phatdattran2k2/recycleright/report/PRESENTATION_FINAL.pptx

RecycleRight

AI-Powered Waste Sorting System on Jetson Orin Nano

陳發達 (611451001) · 楊瑋竣 (411201107)

Supervisor: Prof. 宋建龍 | Tatung University | I4210 AI Edge Computing Practicum | June 2026

## Slide 2

Problem Statement & Motivation

The Problem

Recycling contamination from wrong-bin deposits is the #1 cause of recyclables going to landfill. Taiwan's source-separation rules require 4 distinct categories. Static signs alone don't work.

Why Edge AI on Jetson Orin Nano?

Video never leaves device — no cloud transmission

< 30 ms vs 300+ ms cloud round-trip → servo responds instantly

Servo motors need direct hardware control via ESP32

15–25 W always-on vs 150–350 W desktop GPU

🔒

Privacy

⚡

Latency

Who Benefits

University campuses, cafeterias, office floors — any high-traffic shared space with multi-bin stations. Venue operators, recycling processors, and end-users all benefit.

🔌

GPIO/UART

💡

Power

## Slide 3

Final System Architecture

SENSE

PROCESS

DECIDE

ACT

IMX219 CSI
1280×720 @60fps
GStreamer
nvarguscamerasrc

→

YOLOv8n
TRT FP16
conf ≥ 0.50
~23 ms/frame

→

10-frame vote
≥6 hits wins
lid_ready sync
DONE handshake

→

ESP32+PCA9685
4× SG90 servo
4× status LED
ffplay audio

4 Concurrent Threads

T1 CameraCapture

T2 Detector

T3 SerialController

T4 HUD/tegrastats

ESP32 (USB UART 115200) → PCA9685 I²C (addr 0x40) → 4× SG90 servo | Sequence: LED ON → 120° → 5s hold → 0° → LED OFF → DONE:<label> | lid_ready Event released

## Slide 4

What Changed vs the Proposal

YOLOv8n has more mature TRT FP16 export on JetPack 6 / TRT 10.7. Same accuracy class, better toolchain stability.

Model

❌ YOLOv12n (proposed)

✅ YOLOv8n TRT FP16 (shipped)

Decouples servo PWM from Jetson. DONE handshake provides clean mutual exclusion without asyncio complexity.

Actuator Control

❌ Direct Jetson GPIO servo

✅ ESP32 + PCA9685 via UART

Single-device deployment — direct Python primitives are lower latency and simpler to test than an MQTT round-trip.

Messaging

❌ MQTT broker (Mosquitto)

✅ threading.Queue + Event

GPIO contention with PCA9685 I²C. Low-vote rejections handled by no-action + audio announcement instead.

Red rejection LED

❌ GPIO-driven red LED

✅ Removed

## Slide 5

AI Model & Optimization Choices

YOLOv8n

Architecture

TRT FP16

Precision

640×640

Input Size

4 classes

Categories

0.50

Conf. Threshold

96.02%

mAP@50

Dataset: Custom 12,571 images (10,056 train / 1,257 val / 1,258 test), collected with IMX219 at Tatung University lab. Labeled with Roboflow.
Training: PC server, YOLOv8n pretrained COCO, 100 epochs AdamW, best checkpoint at epoch 0 (pretrained weights already excellent).
Export: model.export(format='engine', half=True) on-device — TRT engine built for Orin Nano SM 8.7 / TRT 10.7 / CUDA 12.6.

Training & Export Pipeline

## Slide 6

Implementation

Highlights

## Slide 7

Implementation Highlights

MOG2 Motion-Gated Inference

Every frame passes MOG2 background subtraction first (~1 ms CPU). YOLO inference (~23 ms GPU) only runs if a foreground contour exceeds MIN_AREA = 500 px². This gate suppresses > 95% of inference calls on idle frames — the reason live GPU utilization is ~55% rather than saturated, preserving thermal headroom for bursty item presentation.

01

10-Frame Majority Voting + lid_ready Interlock

We accumulate VOTE_FRAMES=10 frames and require VOTE_THRESHOLD=6 (≥60%) agreement before dispatching. Once a command is sent, lid_ready.clear() prevents any further dispatch until the ESP32 sends DONE:<label>\n back. Two layers of false-positive protection: statistical confidence + hardware interlock.

02

TRT FP16 On-Device Export

best.pt (FP32) → best_fp16.engine via model.export(format='engine', half=True) running on the Jetson itself. TRT engines are compiled for a specific SM version and CUDA version — never copy .engine files between machines. Export takes ~3–5 min; loads in <2 s at inference time.

03

## Slide 8

Implementation Highlights (continued)

ESP32 Firmware — Busy Guard & Serial Flush

The busy flag in the Arduino loop() ignores all incoming serial bytes during an active sort cycle. After the servo sequence completes, while(Serial.available()) Serial.read() flushes the buffer before sending DONE: — preventing any queued ghost commands from triggering a second sort. Discovered through direct physical observation: the servo opened twice on a single item.

04

5-Stage CI/CD Pipeline on Self-Hosted Jetson Runner

lint → test (≥90% coverage) → security-scan (bandit + pip-audit) → build (arm64 Docker → GHCR) → integration-test (pulls image on Jetson runner, end-to-end test). The conftest.py mock layer lets all unit tests run on Ubuntu cloud runners with no GPU, camera, or serial port. Only integration-test requires the real Jetson.

05

Jetson → ESP32: PET\n | GLS\n | MTL\n | PAP\n ESP32 → Jetson: DONE:PET bottle\n | DONE:Glass bottle\n | ...

UART Protocol:

## Slide 9

CI/CD Pipeline — 5-Stage GitHub Actions

lint

ruff check
zero violations

test

pytest
≥90% coverage

security

bandit
pip-audit

build

arm64 Docker
push GHCR

integration

Jetson runner
end-to-end

Self-Hosted Jetson

→

→

→

→

GitHub-Hosted (Ubuntu — no GPU needed)

Trigger

Push to main
+ Pull Request

Coverage

--cov-fail-under=90
93 tests pass

Security

0 high-severity
bandit findings

Image tag

sha-<commit>
+ :latest float

Deploy

Tag v* triggers
deploy.yml

Tag-triggered deploy.yml: git tag v1.0.0 → push → Jetson runner pulls GHCR image → deploy.sh → healthcheck.sh → rollback.sh available (< 30 s to previous tag)

## Slide 10

Test Set & Methodology

Class

Train

Val

Test

Total

PET bottle

Aluminum can

5,093

2,557

654

304

673

297

6,420

3,158

Glass bottle

2,300

255

305

2,860

Tetra Pak

1,820

271

221

2,312

Total instances

11,770

1,484

1,496

14,750

Accuracy Measurement

• model.val() on held-out test split (1,258 images)
• Eval on best.pt FP32 (training server)
• Deploy as best_fp16.engine (< 0.5 mAP drop expected)
• conf=0.50, IoU=0.70

Performance Instrumentation

• FPS: pipeline-level counter in Detector thread
• Latency: time.perf_counter() around model() call
• GPU%/Power: sudo tegrastats --interval 1000
• Parsed by scripts/parse_tegrastats.py → utilization.csv
• 449 samples @ 1 Hz, ≥60 s sustained live run

## Slide 11

Performance Requirements & Optimization Journey

≥25 FPS

Target FPS

≤60 ms

p95 Latency

≥0.80

mAP@50

≤15 W

VDD_IN

≥40% GPU

GPU Utilization

≤60% CPU

CPU Headroom

Step

Change

FPS

p50 ms

GPU%

Power W

Note

Step 0 — FP32

best.pt 15W

39.5

24.8

73%

8.7 W

Baseline

Step 1 — FP16

TRT FP16 15W

43.1

22.9

67%

7.5 W ↓14%

Best power efficiency

Step 2 — 25W

FP16 + 25W mode

44.8

21.2

62%

7.5 W

Marginal +4% FPS

Step 3 — MAXN

FP16 + MAXN mode

44.4

21.8

66%

7.8 W

No gain vs 25W

Step 4 — Live

MOG2 + 4 threads

gated

N/A

55%

10.8 W

Final deployment

★ All 6 targets met: FPS 43.1≥25 ✅ p95 30.2ms≤60ms ✅ mAP 96.02%≥80% ✅ Power 7.5W≤15W ✅ GPU 55%≥40% ✅ CPU 48.5%≤60% ✅

## Slide 12

Results — Accuracy & Performance

96.02%

mAP@50

96.95%

Precision

96.38%

Recall

96.66%

F1 Score

Per-class AP@50

Aluminum can (best)

Mode

FPS

p50ms

p95ms

97.30%

15W (FP16)

43.1

22.9

30.2

PET bottle

96.19%

25W (FP16)

44.8

21.2

31.8

Tetra Pak

95.65%

MAXN (FP16)

Live Pipeline (tegrastats, 449 samples)

CPU avg: 32.1% GPU avg: 45.3%
VDD_IN avg: 6,712 mW (6.7 W)
VDD_IN peak: 8,124 mW (8.1 W)
No thermal throttling observed

44.4

21.8

30.9

Glass bottle (lowest)

94.95%

## Slide 13

LIVE DEMO

Sense → Process → Decide → Act

1. Jetson powered on — tegrastats visible in corner

2. Live IMX219 CSI camera feed — NOT a pre-recorded video

3. YOLOv8n TRT FP16 inference — bounding boxes + FPS counter

4. 10-frame voting window reaches threshold → decision fires

5. SG90 servo opens to 120° — bin lid physically moves

6. Mandarin audio announcement plays — confirms item category

7. ESP32 sends DONE: → lid closes → system unlocks for next item

(Recorded backup available if live setup fails)

## Slide 14

Lessons Learned

TRT Engine Must Be Built on Target Device

Tried exporting on laptop (x86 CUDA 11.8) and copying .engine to Jetson → GPU architecture mismatch error. TRT compiles for a specific SM version. Always run export_fp16.py on the Jetson itself. Cost us one full day.

1

GStreamer Pipelines Are Not Portable

nvarguscamerasrc only works on JetPack Jetson systems. Our conftest.py mock layer solved this: mock cv2.VideoCapture at import time → 90%+ coverage on cloud runners with no camera.

2

MOG2 Thresholds Require In-Situ Calibration

MIN_AREA=200 triggered false positives from fluorescent flicker. Raised to 500. The right value depends on camera height, lighting, and bin opening size — cannot be determined from a dataset alone.

3

lid_ready Interlock Was Not in the Original Design

Discovered in integration testing: removing an item before the vote window closed could queue two commands. The Event-based interlock completely eliminates this race condition. Patterns we didn't anticipate during the proposal phase.

4

tegrastats Format Changed in JetPack 6.x

VDD_CPU_GPU_CV replaced POM_5V_GPU. CPU frequency format changed. Our parse_tegrastats.py uses regex fallbacks for both JetPack 5 and 6. Always test parsers against actual log output before trusting numbers.

5

## Slide 15

What We'd Do Differently

Decide INT8 vs FP16 at Week 1, not Week 13. We scaffolded a calibration/ directory but never populated it. Benchmark both on a small test set early and commit to one path.

1

Both

Write integration tests before wiring the actuator. We spent Week 13 retrofitting tests around code that was already running on hardware. Contracts first, implementation second.

2

楊瑋竣

Run class-distribution analysis at Week 9, not Week 14. Glass bottle AP was lowest (94.95%). Knowing this earlier would have let us collect more samples while time permitted.

3

陳發達

Pin nvpmodel mode in deploy.sh. During demos we forgot which power mode was active. One line of sudo nvpmodel -m 1 in deploy.sh ensures reproducible performance on every deploy.

4

陳發達

Register the self-hosted Jetson runner at Week 10, not Week 14. Setup takes 30 minutes. Starting earlier means catching integration failures weeks sooner, when there's still time to fix them.

5

Both

## Slide 16

Thank You

Questions & Answers

陳發達 (611451001) — Hardware integration, ESP32 firmware, dataset, model training, benchmarking

楊瑋竣 (411201107) — Software architecture, CI/CD pipeline, test suite, parse_tegrastats.py

Anticipate:

❓ Why YOLOv8n over YOLOv12n?

❓ What if the camera disconnects?

❓ How would this scale to 50 devices?

❓ What's the worst failure mode observed?

❓ Walk through what CI does on a PR

GitHub: github.com/phatdattran2k2/recycleright | Supervisor: Prof. 宋建龍 | June 2026
