phatdattran2k2/recycleright/scripts/benchmark_offline_result.csv

timestamp | power_mode | n_images | loops | fps | n_samples | p50_ms | p95_ms | p99_ms | mean_ms | min_ms | max_ms | cpu_avg_pct | gpu_avg_pct | vdd_in_avg_mw | vdd_in_peak_mw
2026-06-07 22:49:10 | Mode 0 (15W) | 320 | 3 | 43.1 | 960 | 22.9 | 30.2 | 35.2 | 23.2 | 14.6 | 50.2 | 39.1 | 66.5 | 7507 | 8464
2026-06-07 22:50:27 | Mode 1 (25W) | 320 | 3 | 44.8 | 960 | 21.2 | 31.8 | 34.6 | 22.3 | 14.3 | 37.2 | 36.6 | 61.9 | 7459 | 7888
2026-06-07 22:51:23 | Mode 2 (MAXN_SUPER) | 320 | 3 | 44.4 | 960 | 21.8 | 30.9 | 35.1 | 22.5 | 14.7 | 37.3 | 37.2 | 65.6 | 7833 | 9066
