phatdattran2k2/recycleright/report/test_CI_CD.png

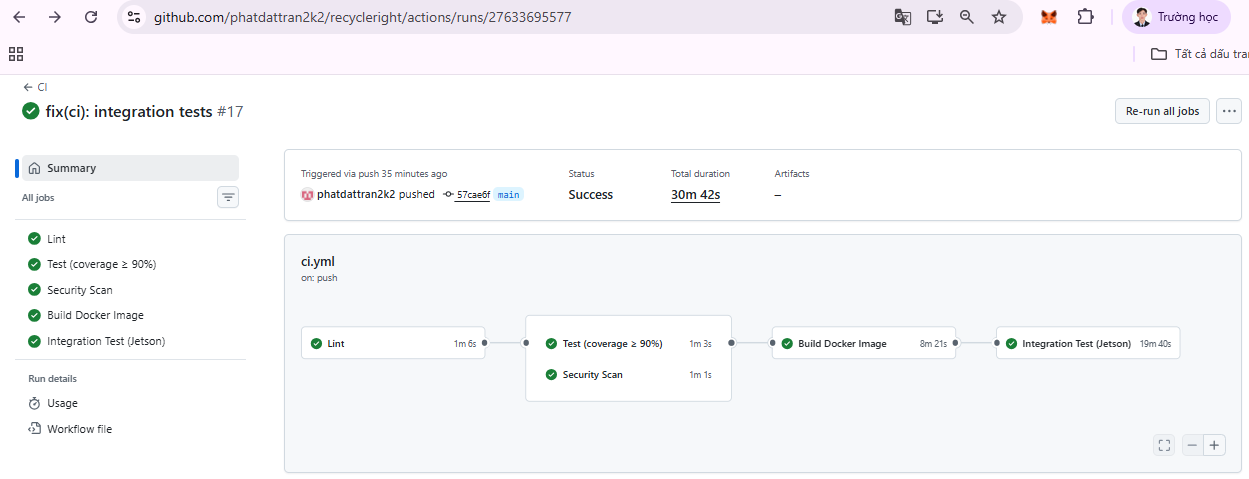
report/test_CI_CD.png
