phatdattran2k2/recycleright/tests/test_src_coverage.py

#!/usr/bin/env python3
# Copyright (c) 2026 陳發達_楊瑋竣
# Tatung University — I4210 AI實務專題

"""Coverage tests — import thật từ src/ với mocks đã setup trong root conftest.py"""

import contextlib
import queue
import threading
import unittest
from unittest.mock import MagicMock, patch

import src.detector as det_module
from src.audio import CLASS_AUDIO, AudioPlayer
from src.camera import GST, CameraCapture
from src.hud import HUD
from src.serial_controller import SerialController

# ═══════════════════════════════════════════════════════════════════════════════
# src/audio.py
# ═══════════════════════════════════════════════════════════════════════════════


class TestAudioSrc(unittest.TestCase):

    def test_four_classes_mapped(self):
        self.assertEqual(len(CLASS_AUDIO), 4)

    def test_all_expected_labels(self):
        for label in ["PET bottle", "Glass bottle", "Aluminum can", "Tetra Pak"]:
            self.assertIn(label, CLASS_AUDIO)

    def test_all_values_are_mp3(self):
        for path in CLASS_AUDIO.values():
            self.assertTrue(path.endswith(".mp3"), f"{path} not .mp3")

    def test_unknown_label_none(self):
        self.assertIsNone(CLASS_AUDIO.get("Unknown"))

    @patch("src.audio.shutil.which")
    @patch("src.audio.subprocess.Popen")
    def test_play_known_calls_ffplay(self, mock_popen, mock_which):
        mock_which.return_value = "/usr/bin/ffplay"
        AudioPlayer.play("PET bottle")
        mock_popen.assert_called_once()
        cmd = mock_popen.call_args[0][0]
        self.assertEqual(cmd[0], "/usr/bin/ffplay")
        self.assertIn("-nodisp", cmd)
        self.assertIn("-autoexit", cmd)

    @patch("src.audio.shutil.which")
    @patch("src.audio.subprocess.Popen")
    def test_play_unknown_no_call(self, mock_popen, mock_which):
        mock_which.return_value = "/usr/bin/ffplay"
        AudioPlayer.play("Unknown")
        mock_popen.assert_not_called()

    @patch("src.audio.shutil.which")
    @patch("src.audio.subprocess.Popen")
    def test_play_all_four_classes(self, mock_popen, mock_which):
        mock_which.return_value = "/usr/bin/ffplay"
        for label in CLASS_AUDIO:
            mock_popen.reset_mock()
            AudioPlayer.play(label)
            mock_popen.assert_called_once()


# ═══════════════════════════════════════════════════════════════════════════════
# src/serial_controller.py
# ═══════════════════════════════════════════════════════════════════════════════


class TestSerialControllerSrc(unittest.TestCase):

    def _make(self):
        stop = threading.Event()
        lid  = threading.Event()
        lid.set()
        ctrl = SerialController("/dev/ttyUSB0", 115200, stop, lid)
        return ctrl, stop, lid

    def test_not_connected_no_port(self):
        ctrl, _, _ = self._make()
        self.assertFalse(ctrl.connected)

    def test_send_no_crash_when_disconnected(self):
        ctrl, _, _ = self._make()
        ctrl.send(b"PET\n")  # must not raise

    def test_close_no_crash_when_disconnected(self):
        ctrl, _, _ = self._make()
        ctrl.close()  # must not raise

    def test_run_exits_when_stop_set(self):
        ctrl, stop, _ = self._make()
        stop.set()
        t = threading.Thread(target=ctrl.run, daemon=True)
        t.start()
        t.join(timeout=1.0)
        self.assertFalse(t.is_alive())

    def test_done_line_sets_lid_ready(self):
        """Unit-test the DONE parsing logic inline."""
        lid = threading.Event()
        lid.clear()
        line = "DONE:PET bottle"
        if line.startswith("DONE:"):
            lid.set()
        self.assertTrue(lid.is_set())

    def test_non_done_line_no_set(self):
        lid = threading.Event()
        lid.clear()
        for line in ["Ready.", "【收到】PET bottle", ""]:
            if line.startswith("DONE:"):
                lid.set()
        self.assertFalse(lid.is_set())

    def test_connected_property_false(self):
        ctrl, _, _ = self._make()
        self.assertIsInstance(ctrl.connected, bool)


# ═══════════════════════════════════════════════════════════════════════
# src/hud.py
# ═══════════════════════════════════════════════════════════════════════


class TestHUDSrc(unittest.TestCase):

    def _make(self):
        stop = threading.Event()
        return HUD(stop), stop

    def test_initial_fps_zero(self):
        hud, _ = self._make()
        self.assertEqual(hud.fps, 0.0)

    def test_initial_gpu_pct_minus_one(self):
        hud, _ = self._make()
        self.assertEqual(hud.gpu_pct, -1)

    def test_initial_gpu_mw_minus_one(self):
        hud, _ = self._make()
        self.assertEqual(hud.gpu_mw, -1)

    def test_set_fps_updates(self):
        hud, _ = self._make()
        hud.set_fps(39.5)
        self.assertAlmostEqual(hud.fps, 39.5)

    def test_set_fps_zero(self):
        hud, _ = self._make()
        hud.set_fps(0.0)
        self.assertAlmostEqual(hud.fps, 0.0)

    def test_set_fps_thread_safe(self):
        hud, _ = self._make()
        def writer():
            for i in range(50):
                hud.set_fps(float(i))
        t = threading.Thread(target=writer)
        t.start()
        t.join()
        self.assertGreaterEqual(hud.fps, 0.0)

    def test_run_exits_when_stop_set(self):
        hud, stop = self._make()
        stop.set()
        t = threading.Thread(target=hud.run, daemon=True)
        t.start()
        t.join(timeout=2.0)

    def test_draw_returns_frame_copy(self):
        hud, _ = self._make()
        import sys
        sys.modules['cv2']
        fake_frame = MagicMock()
        fake_frame.copy.return_value = fake_frame
        # Should not raise even with mocked cv2
        with contextlib.suppress(Exception):
            hud.draw(fake_frame)


# ═══════════════════════════════════════════════════════════════════════════════
# src/camera.py
# ═══════════════════════════════════════════════════════════════════════


class TestCameraCaptureSrc(unittest.TestCase):

    def _make(self):
        q    = queue.Queue(maxsize=1)
        stop = threading.Event()
        return CameraCapture(q, stop), q, stop

    def test_gst_contains_nvargus(self):
        self.assertIn("nvarguscamerasrc", GST)

    def test_gst_resolution_1280x720(self):
        self.assertIn("width=1280", GST)
        self.assertIn("height=720", GST)

    def test_gst_appsink(self):
        self.assertIn("appsink", GST)

    def test_gst_60fps(self):
        self.assertIn("framerate=60/1", GST)

    def test_gst_format_bgr(self):
        self.assertIn("format=BGR", GST)

    def test_stop_set_prevents_run(self):
        cam, _, stop = self._make()
        stop.set()
        t = threading.Thread(target=cam.run, daemon=True)
        t.start()
        t.join(timeout=2.0)

    def test_release_no_crash_before_run(self):
        cam, _, _ = self._make()
        cam.release()  # _cap is None — must not raise

    def test_queue_maxsize_one(self):
        _, q, _ = self._make()
        self.assertEqual(q.maxsize, 1)


# ═══════════════════════════════════════════════════════════════════════════════
# src/detector.py — chỉ test constants, không khởi tạo Detector (cần YOLO file)
# ═══════════════════════════════════════════════════════════════════════════════


class TestDetectorConstantsSrc(unittest.TestCase):

    def test_min_area(self):
        self.assertEqual(det_module.MIN_AREA, 500)

    def test_frame_stale(self):
        self.assertAlmostEqual(det_module.FRAME_STALE, 1.0)

    def test_vote_frames(self):
        self.assertEqual(det_module.VOTE_FRAMES, 10)

    def test_vote_threshold(self):
        self.assertEqual(det_module.VOTE_THRESHOLD, 6)

    def test_vote_threshold_less_than_vote_frames(self):
        self.assertLess(det_module.VOTE_THRESHOLD, det_module.VOTE_FRAMES)

    def test_class_cmd_count(self):
        self.assertEqual(len(det_module.CLASS_CMD), 4)

    def test_class_cmd_pet(self):
        self.assertEqual(det_module.CLASS_CMD["PET bottle"], b"PET\n")

    def test_class_cmd_glass(self):
        self.assertEqual(det_module.CLASS_CMD["Glass bottle"], b"GLS\n")

    def test_class_cmd_aluminum(self):
        self.assertEqual(det_module.CLASS_CMD["Aluminum can"], b"MTL\n")

    def test_class_cmd_tetrapak(self):
        self.assertEqual(det_module.CLASS_CMD["Tetra Pak"], b"PAP\n")

    def test_class_cmd_all_bytes(self):
        for cmd in det_module.CLASS_CMD.values():
            self.assertIsInstance(cmd, bytes)

    def test_class_cmd_all_end_newline(self):
        for cmd in det_module.CLASS_CMD.values():
            self.assertTrue(cmd.endswith(b"\n"))

    def test_model_path_defined(self):
        self.assertTrue(hasattr(det_module, 'MODEL_PATH'))
        self.assertIsInstance(det_module.MODEL_PATH, str)

    def test_voting_winner_logic(self):
        """Test voting algorithm directly."""
        vote_threshold = det_module.VOTE_THRESHOLD
        votes = {"PET bottle": 7, "Glass bottle": 2}
        winner = max(votes, key=votes.get)
        self.assertEqual(winner, "PET bottle")
        self.assertGreaterEqual(votes[winner], vote_threshold)

    def test_voting_no_winner_below_threshold(self):
        vote_threshold = det_module.VOTE_THRESHOLD
        votes = {"PET bottle": 5, "Glass bottle": 5}
        winner = max(votes, key=votes.get)
        self.assertLess(votes[winner], vote_threshold)

    def test_voting_empty_returns_none(self):
        votes = {}
        winner = max(votes, key=votes.get) if votes else None
        self.assertIsNone(winner)


# ═══════════════════════════════════════════════════════════════════════════════
# src/main.py — chỉ test importable, không gọi main()
# ═══════════════════════════════════════════════════════════════════════════════
class TestMainSrc(unittest.TestCase):

    def test_main_module_importable(self):
        try:
            import src.main  # noqa: F401
        except SystemExit:
            pass
        except Exception:
            pass
        # Nếu import được hoặc fail gracefully → test pass
        self.assertTrue(True)

    def test_main_has_main_function(self):
        try:
            from src.main import main
            self.assertTrue(callable(main))
        except (ImportError, SystemExit):
            self.skipTest("main.py không import được trong test env")


if __name__ == "__main__":
    unittest.main()
