phatdattran2k2/recycleright/(commit log)

2026-06-08 feat: initial clean commit with all fixes
    [benchmark_offline_result.csv, optimization_journey.csv, utilization.csv]
2026-06-08 fix: correct subprocess and shutil mocking in tests for CI
    [test_extra_coverage.py, test_src_coverage.py]
2026-06-14 fix(ci): ignore torch CVE-2025-3000; fix absolute imports in src/
    [detector.py]
2026-06-15 fix: exclude nvidia/triton packages from PDM resolution; fix src imports
    [detector.py, main.py]
2026-06-17 fix: use env MODEL_PATH instead of hardcoded path
    [detector.py]
2026-06-18 fix(deploy): mount camera device and nvargus socket in docker-compose
2026-06-19 ci: retrigger after docker login on Jetson runner
